Neil-Neflex/Amstrong-AmberV/IMG/IMG-7660.jpg

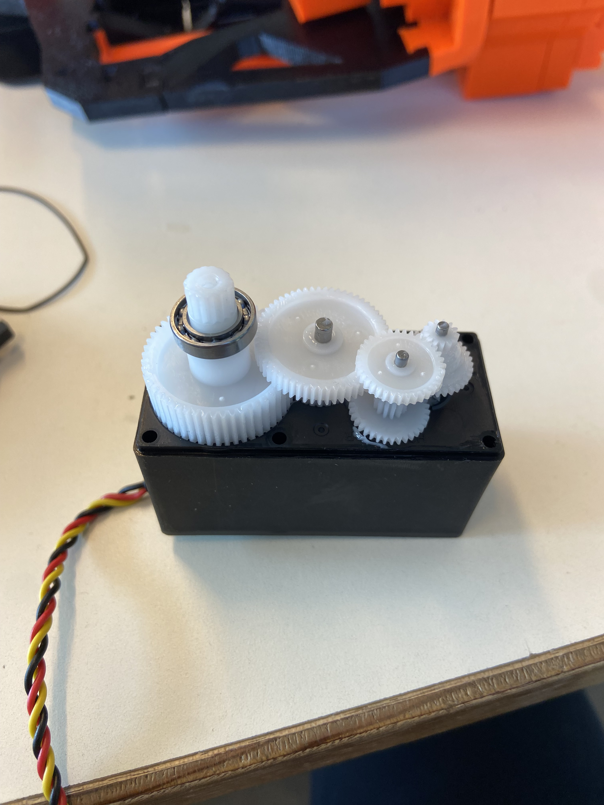
IMG/IMG-7660.jpg
