Neil-Neflex/Amstrong-AmberV/Compte-rendus_de_séances/Ambre_Vuaillat/Séance #8.pdf

03/03/2023

## Séance 8

Temps de travail : 3h

Tâches effectuées :

- Finition du servomoteur de l’épaule
- Test servomoteur biceps

Lors de cette dernière séance, j’ai retiré la butée et finis la soudure du potentiomètre du servo moteur de l’épaule. Après avoir réassembler le servomoteur de l’épaule, j’ai réassemblé le servomoteur du biceps avec la vis sans fin pour procéder à son test.

Lors de ce test, nous nous sommes rendu compte que notre servomoteur ne fonctionnait pas nous devons donc déterminer la cause du disfonctionnement. On pense que cela peut être du au mauvais placement des engrenages dans le servomoteur on doit donc le redémonter pour replacer les engrenages et vérifier si le disfonctionnement provient de ça ou non.
