Neil-Neflex/Amstrong-AmberV/Compte-rendus_de_séances/Ambre_Vuaillat/Séance complémentaire #2.pdf

23/02/2023

## Séance complémentaire 2

Temps de travail : 2 heures

Tâches effectuées :

- Retrait de la butée du servomoteur du coude
- Test du servomoteur
- Démontage du servomoteur

Lors de cette séance complémentaire, j’ai redémonter le servomoteur du coude pour enlever la butée car on avait remarqué que cela empêchait notre bras d’atteindre l’amplitude de mouvement souhaité. J’ai ensuite pu tester le bon fonctionnement du servomoteur avant de pouvoir le remonter sur l’épaule.

Pour finir, j’ai commencé à démonter le servomoteur de l’épaule pour retirer le potentiomètre et enlever la butée comme pour celui du coude.
