Neil-Neflex/Amstrong-AmberV/Compte-rendus_de_séances/Ambre_Vuaillat/Séance complémentaire #3.pdf

03/03/2023

## Séance complémentaire 3

Temps de travail : 1h30

Tâches effectuées :

- Test servomoteur
- Recherche des causes des disfonctionnements

Lors de cette séance complémentaire, j’ai procédé au test du servomoteur de l’épaule. Ce test m’a permis de voir que le potentiomètre ne fonctionnait pas ce qui provoque la rotation en continue du servomoteur. Pour tenter de palier à ce disfonctionnement, nous allons refaire les soudures du potentiomètre et si cela ne fonctionne pas nous seront obligés de nous servir d’un autre servomoteur.

Pour le servomoteur du biceps, j’ai procédé à son démontage pour remettre en place les engrenages sauf que je n’ai pas pu retirer le palonnier qui est vissé au servomoteur car nous avions mis de la colle forte ce qui a bloqué la vis. On doit donc trouver une solution pour désolidariser cette pièce du servomoteur ou pour remonter le servomoteur sans désolidariser la pièce.
