Neil-Neflex/Amstrong-AmberV/Compte-rendus_de_séances/Ambre_Vuaillat/Séance #4.pdf

03/02/2023

## Séance 4

Temps de travail : 3h

Taches effectuées :

- Montage du reste du bras robotisé

Lors de cette séance nous avons commencer le montage du biceps et de l’épaule de notre bras robotisé.

Pour procéder à l’assemblage des pièces, il a fallu poncer plusieurs pièces qui vont être mise en rotation car l’excèdent de matière nous empêchait d’emboiter les pièces et bloquait la rotation.

Nous avons ensuite commencé l’assemblage que nous continuerons lors d’une prochaine séance de cours ou lors d’une séance complémentaire.
