Neil-Neflex/Amstrong-AmberV/Compte-rendus_de_séances/Ambre_Vuaillat/Séance #5.pdf

03/02/2023

## (Séance 5

Temps de travail : 3 heures

Tâche effectuée :

- Début de l’assemblage du reste du bras
- Nettoyage des pièces

Lors de cette séance, nous avons commencer l’assemblage du reste de notre bras robotisé (Biceps et épaule).

Avant de procéder à l’assemblage de notre bras il a fallu nettoyer, poncer et graisser certaines pièces permettant la mise en rotation de notre bras ce qui nous a pris beaucoup de temps et ne nous a donc pas permis d’avancer aussi vite que souhaité.
