Neil-Neflex/Amstrong-AmberV/Compte-rendus_de_séances/Ambre_Vuaillat/Séance #6.pdf

10/02/2023

## Séance 6

Temps de travail : 3 heures

Tâche effectuée :

- Assemblage complet du bras robotisé
- Test du bras
- Recherche et développement du support de notre bras

Cette séance nous a permis de finir d’assembler notre bras et de le tester.

Nous avons aussi commencé à rechercher un support pour notre bras, pour cela on a du prendre en compte le contre poids crée par le bras et nous avons donc décidé de partir sur une base en bois maintenue à la table à l’aide de serre joins et sur une barre en acier à laquelle notre bras sera accroché.

Suite à cette réflexion, nous avons trouvé une barre en acier et commencé à la poncer pour la rendre plus propre.
