Neil-Neflex/Amstrong-AmberV/Compte-rendus_de_séances/Ambre_Vuaillat/Séance #7.pdf

17/02/2023

## Séance 7

Temps de travail : 3h

Tâches effectuées :

- Soudure nappe de câble
- Récupération du potentiomètre
- Ponçage de la barre en acier
- Test du bras

Lors de cette séance nous avons continué à souder nos nappes de câbles, nous avons ensuite démonté un servomoteur pour récupérer le potentiomètre qui se trouve à l’intérieur. La récupération du potentiomètre devait nous permettre d’augmenter l’angle de rotation de notre bras mais nous nous sommes rendu compte lors des tests qu’il faut aussi se débarrasser de la butée présente dans le servomoteur pour une rotation optimale car pour l’instant notre bras n’atteint pas l’angle de rotation souhaité.
