Neil-Neflex/Amstrong-AmberV/Compte-rendus_de_séances/Neil_Amrane/Séance #5 - Neil.pdf

03/02/23

## Compte rendu séance #5

Projet RACAI Z-34

Tâches accomplies :

- Début de l’assemblage du reste du bras
- Nettoyage des pièces

Temps de travail : 3 heures
PRCS : problème rencontré au cours de la séance

Cette séance a été exclusivement consacrée au nettoyage des pièces. En effet, après le début de l’assemblage du bras, nous avons constaté que les pièces en contact, notamment dans le coude et l’épaule, ne disposaient pas d’assez de jeu pour tourner librement. Après identification des pièces, j’ai entrepris l’assemblage du biceps, je me suis ensuite attelé à graisser le premier axe de rotation du biceps.

J’ai poursuivi ma séance en ponçant le reste des pièces avec ma partenaire.
