Neil-Neflex/Amstrong-AmberV/Compte-rendus_de_séances/Ambre_Vuaillat/Séance #1 - Ambre.pdf

16/12/2022

## Rapport de la séance 1

Lors de cette première séance, j’ai réalisé la liste du matériel nécessaire pour l’assemblage de notre bras robotisé.

La réalisation de cette liste m’a permis de prendre connaissance des différentes étapes de l’assemblage.

Finalement, j’ai récupéré les modèles de pièce 3D pour pouvoir les imprimer.
