Neil-Neflex/Amstrong-AmberV/Compte-rendus_de_séances/Neil_Amrane/Séance #1  - Neil.pdf

16/12/22

## Compte rendu séance #1

Projet MexBot Z-34

Tâches accomplies :

- Finalisation du cahier des charge
- Recherches concernant les capteurs d’activité musculaire
- Recherches concernant le fonctionnement de l’accéléromètre MPU6050
- Récupération des six premiers servomoteurs MG995
- Montage des moteurs dans la structure de l’avant-bras du MexBot
- Début du codage de la main du robot
- Impression de la nouvelle structure de l’avant bras

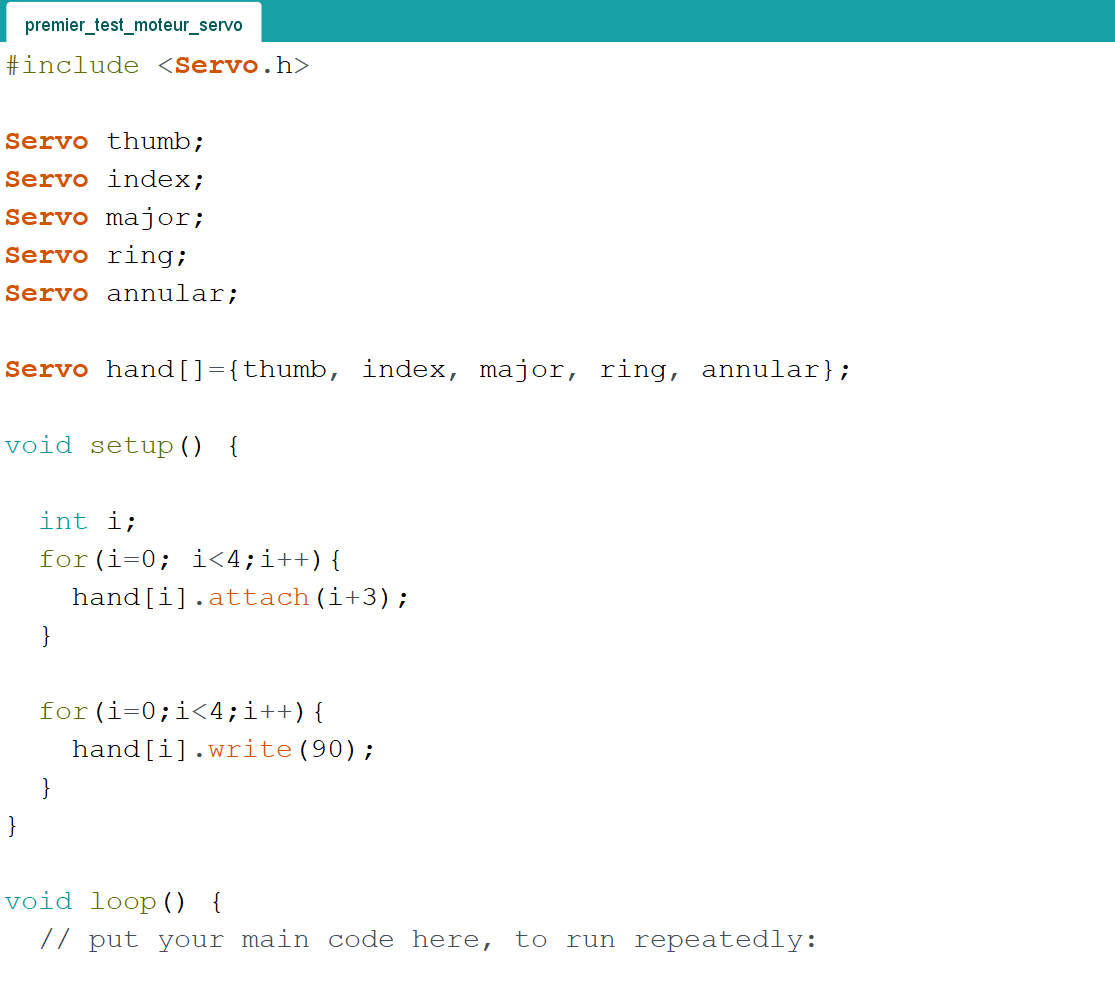
[picture p14: figure]
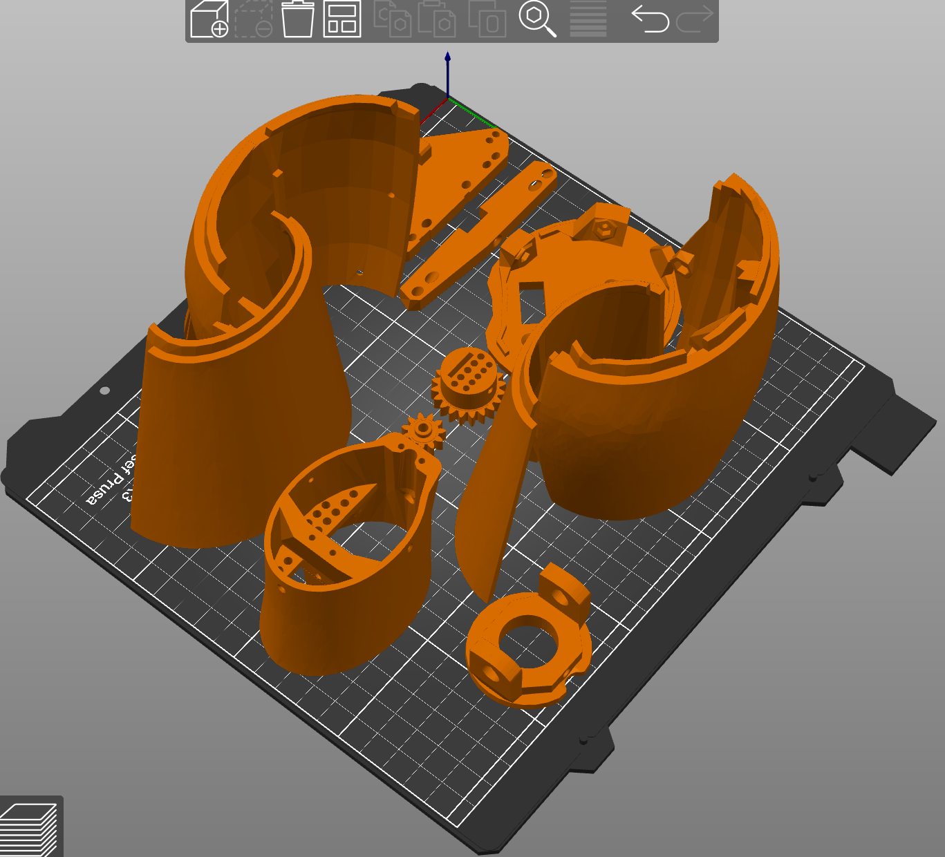
[picture p15: figure]
